SJohnston95/2.4-Ghz--Low-Noise-Amplifier/20180517_154735.jpg

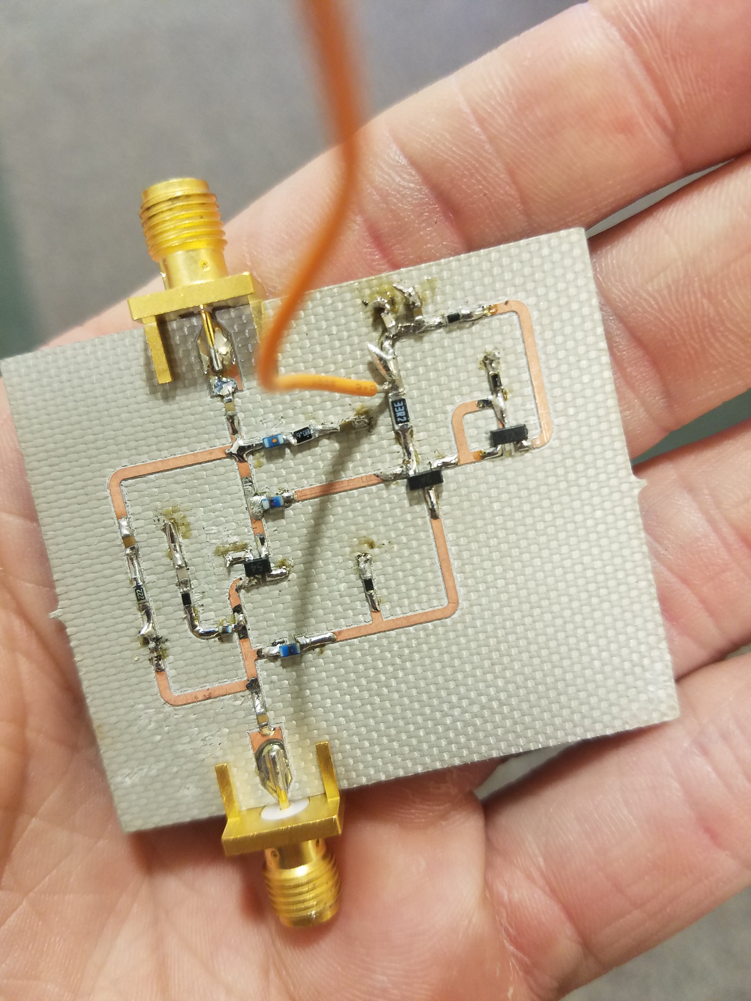
20180517_154735.jpg
